UpLateGeek/Let-s-Make-Some-Memories/README.md

# Let's Make Some Memories

4MB 30 pin SIMM project

Special thanks to Adrian Black from [Adrian's Digital Basement](https://www.youtube.com/c/adriansdigitalbasement).
