UpLateGeek/Let-s-Make-Some-Memories/BOM.md

---
title: Bill of Materials
---

# Bill of Materials: 4MB 30 pin SIMM project

## Assembly List

| Label | Part Type | Properties |
| ----- | --- | --- |
| C1 | SMD ceramic capacitors | 100nF 1206 |
| C2 | SMD ceramic capacitors | 100nF 1206 |
| C3 | SMD ceramic capacitors | 100nF 1206 |
| IC1 | 4M x 4-bit SOJ-24/26 DRAM | TC5117400CSJ, TC5117400BSJ, K4F160411D-B, KM44C4100CK, M5M417400CJ, MCM517400CJ, TMS417400ADJ |
| IC2 | 4M x 4-bit SOJ-24/26 DRAM | TC5117400CSJ, TC5117400BSJ, K4F160411D-B, KM44C4100CK, M5M417400CJ, MCM517400CJ, TMS417400ADJ |
| IC3 | 4M x 1-bit SOJ-20/26 DRAM  | HYB514100BJ, MCM54100AN, MSM514100D-SJ, TMS44100DJ  |

## Shopping List

| Amount | Part Type | Properties |
| --- | --- | --- |
| 3 | SMD ceramic capacitors | 100nF 1206 |
| 2 | 4M x 4-bit SOJ-24/26 DRAM | TC5117400CSJ, TC5117400BSJ, K4F160411D-B, KM44C4100CK, M5M417400CJ, MCM517400CJ, TMS417400ADJ |
| 1<sup id="a1">[1](#f1)</sup> | 4M x 1-bit SOJ-20/26 DRAM  | HYB514100BJ, MCM54100AN, MSM514100D-SJ, TMS44100DJ  |

<b id="f1">1</b> These are only needed if you want a parity module. [↩](#a1)
