UpLateGeek/Let-s-Make-Some-Memories/Schematic v1.pdf

# C1 VCC GND 14*2 1*2 IC1PVCC GND 14*2 1*2 IC2PVCC GND 26 13 IC3P

Sheet: ABCD | 1 | 2 | 3 | 4 | 5 | 6 | ABCD 1 | 2 | 3 | 4 | 5 | 6

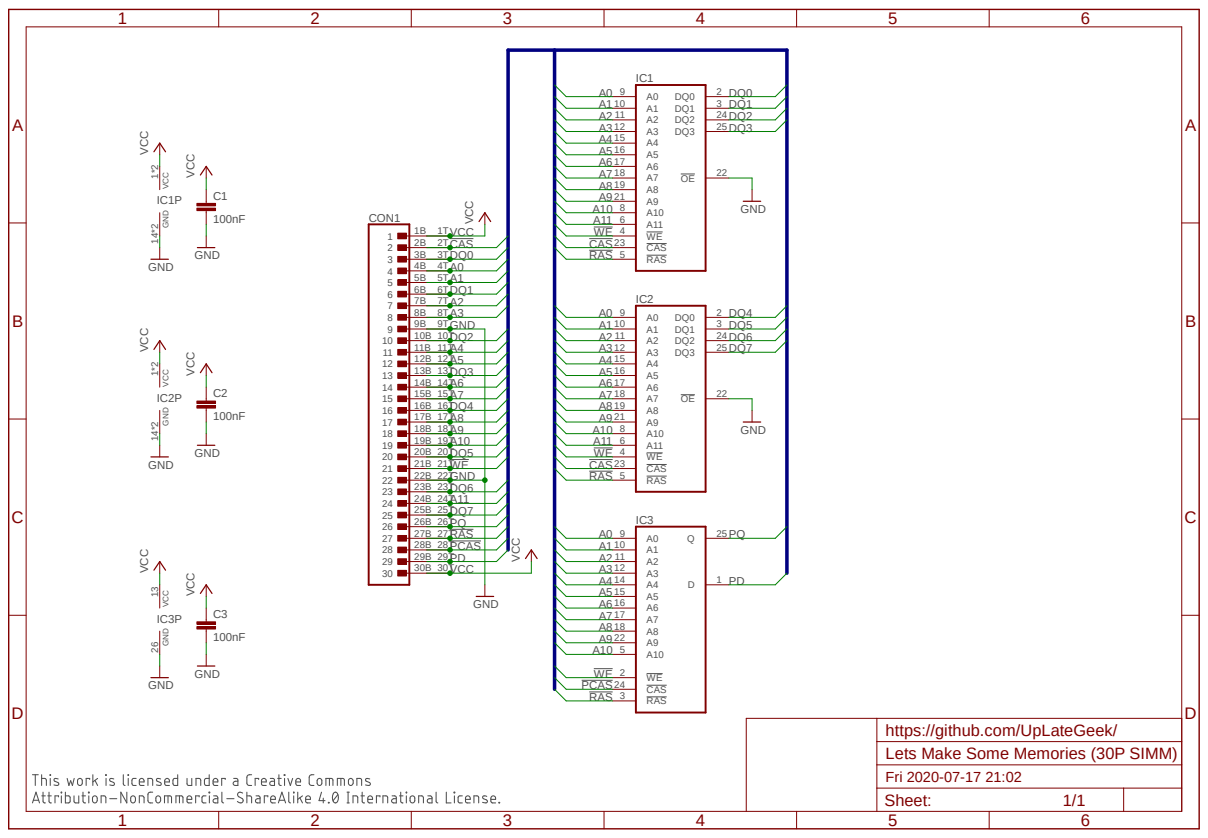
[picture p1: page 1]
GND; GND VCC; VCC VCC; VCC VCC VCC; CON1; WE 4 CAS 23 RAS 5; WE 2 CAS 24; RAS 3; CAS; GND DQ2; RAS; PCAS; VCC

https://github.com/UpLateGeek/
Lets Make Some Memories (30P SIMM)
Fri 2020-07-17 21:02
