UpLateGeek/Let-s-Make-Some-Memories/(commit log)

2020-10-24 Rev. 24 Gerbers
    [copper_bottom.gbr, copper_top.gbr, drill_1_16.xln, gerber_job.gbrjob, profile.gbr, silkscreen_bottom.gbr, silkscreen_top.gbr, soldermask_bottom.gbr]
2020-10-24 Schematic v1
2020-11-02 Update BOM.md
    Added capacitor size, alternate DRAM part numbers, and updated DRAM footprint
2020-11-02 Update BOM.md
    Removed duplicate part number.
2020-11-04 Update BOM.md
    Updated DRAM part numbers - removed timing suffix.
